lab11/observer/README.md

Observer
========

Observer is an indoor monitoring sensor platform that is optimized to work
with [GAP](https://github.com/lab11/gap).
