lab11/observer/contiki/apps/radio_bbb/resources_bbb/images/accel.png

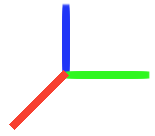
contiki/apps/radio_bbb/resources_bbb/images/accel.png
