lab11/observer/contiki/apps/radio_bbb/resources_bbb/images_2/accel.png

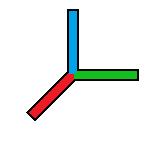
contiki/apps/radio_bbb/resources_bbb/images_2/accel.png
