lab11/observer/contiki/apps/radio_bbb/resources_bbb/images_2/humid.png

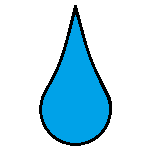
contiki/apps/radio_bbb/resources_bbb/images_2/humid.png
