lab11/observer/contiki/apps/radio_bbb/resources_bbb/images_2/light.png

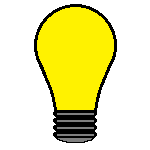
contiki/apps/radio_bbb/resources_bbb/images_2/light.png
