lab11/observer/contiki/apps/radio_bbb/resources_bbb/images_2/press_handle.png

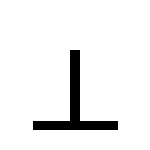
contiki/apps/radio_bbb/resources_bbb/images_2/press_handle.png
