lab11/observer/contiki/apps/radio_bbb/resources_bbb/images_2/template_6.png

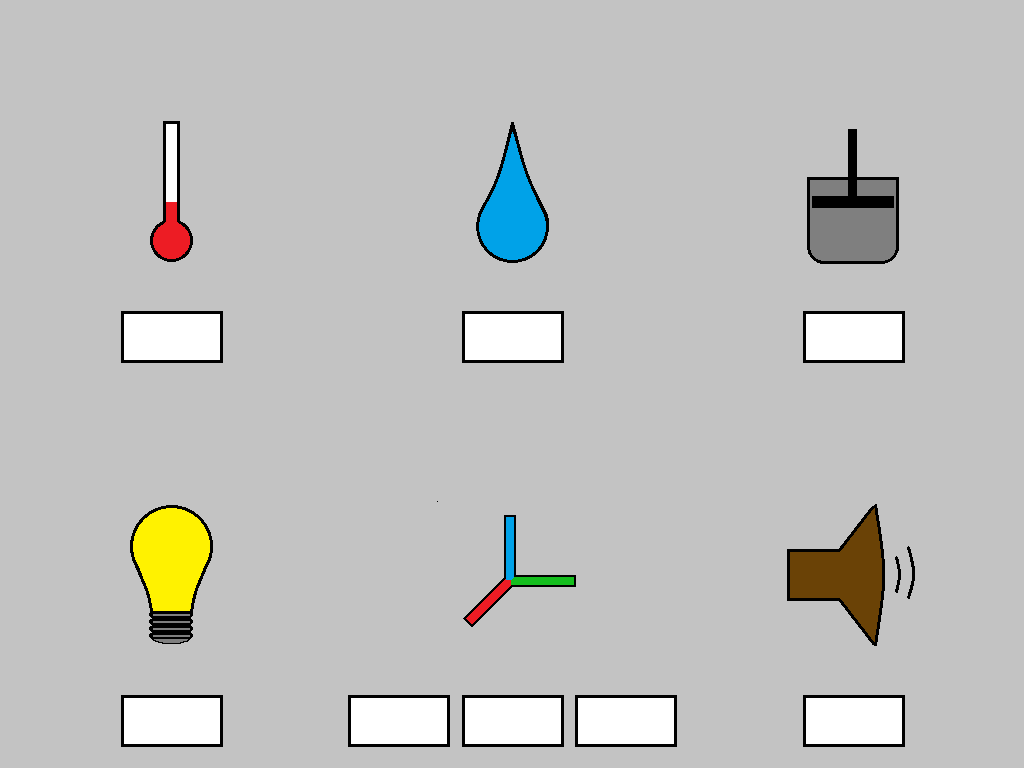
contiki/apps/radio_bbb/resources_bbb/images_2/template_6.png
