lab11/observer/hardware/ocape/rev_a/ocape_pcb.png

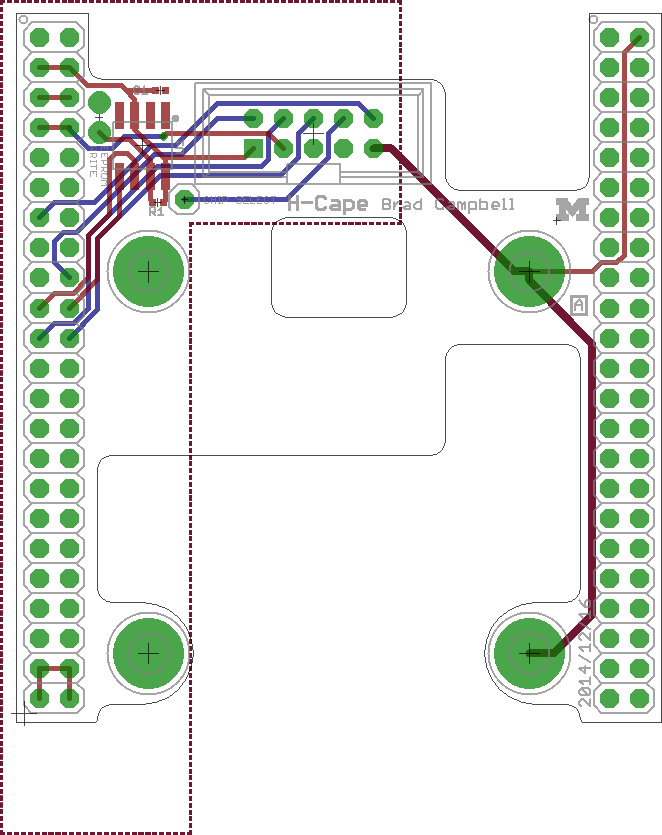
hardware/ocape/rev_a/ocape_pcb.png
