lab11/observer/hardware/ocape/rev_a/ocape.pdf

# BeagleBone Black Header

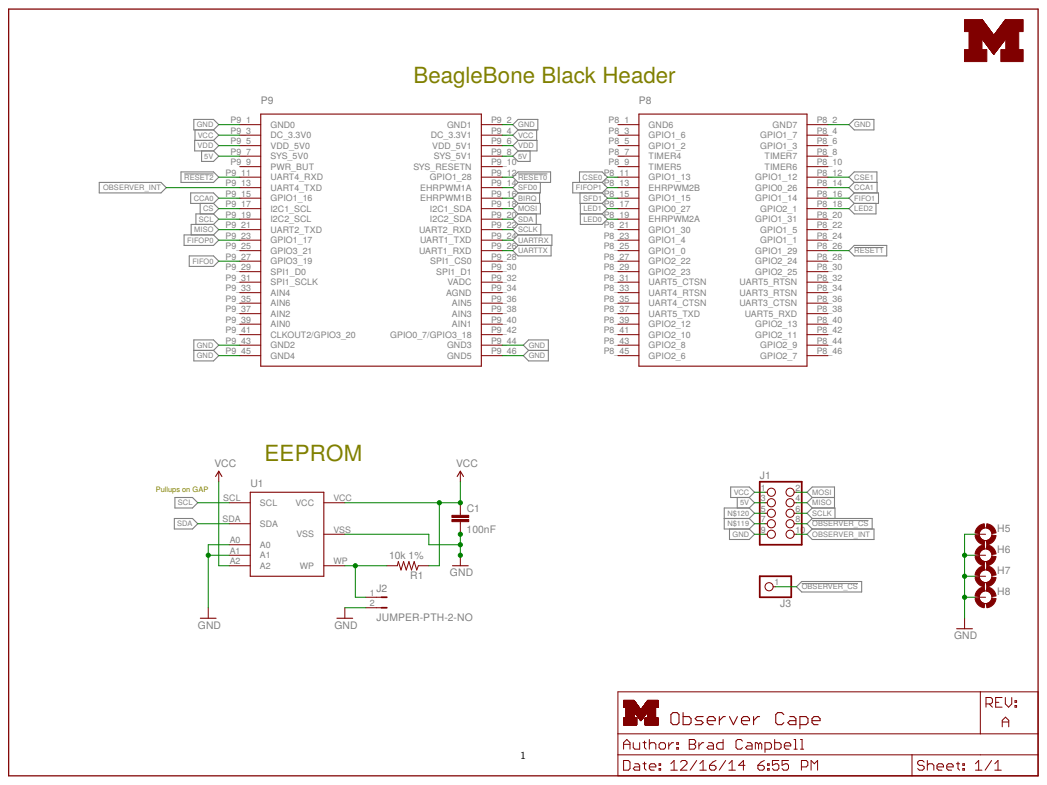
[picture p11: page 1]

Pullups on GAP VCC

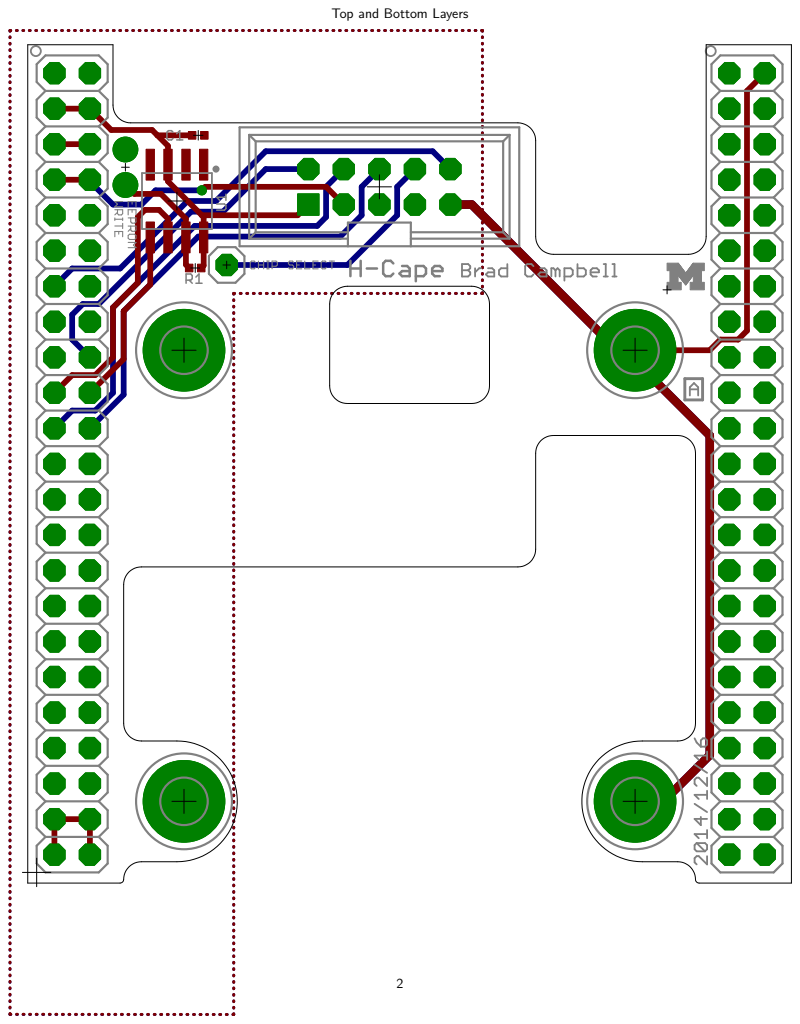
[picture p12: page 2]

Top and Bottom Layers

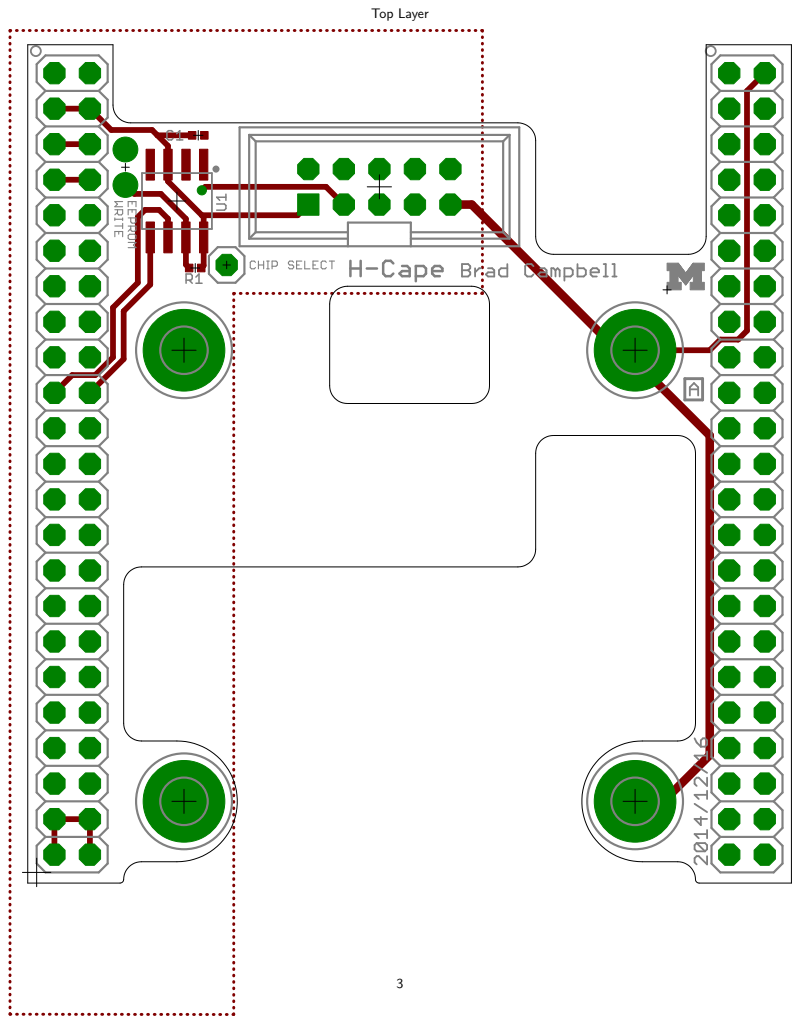
[picture p13: page 3]
Top Layer

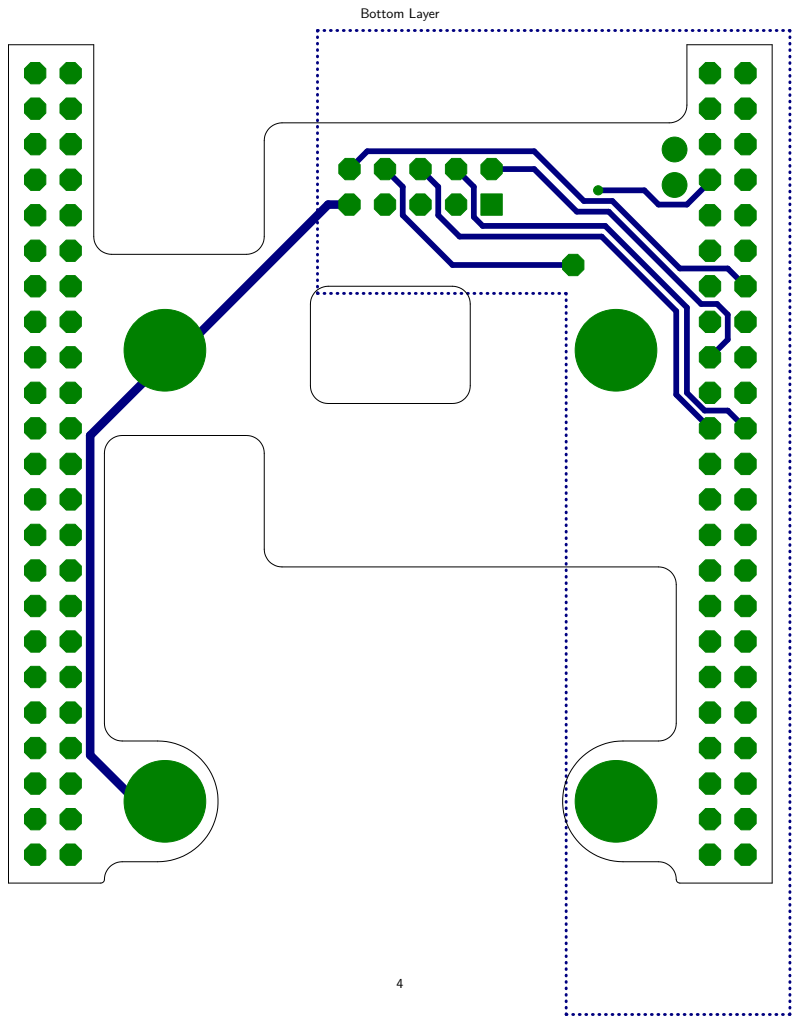
[picture p14: page 4]
Bottom Layer

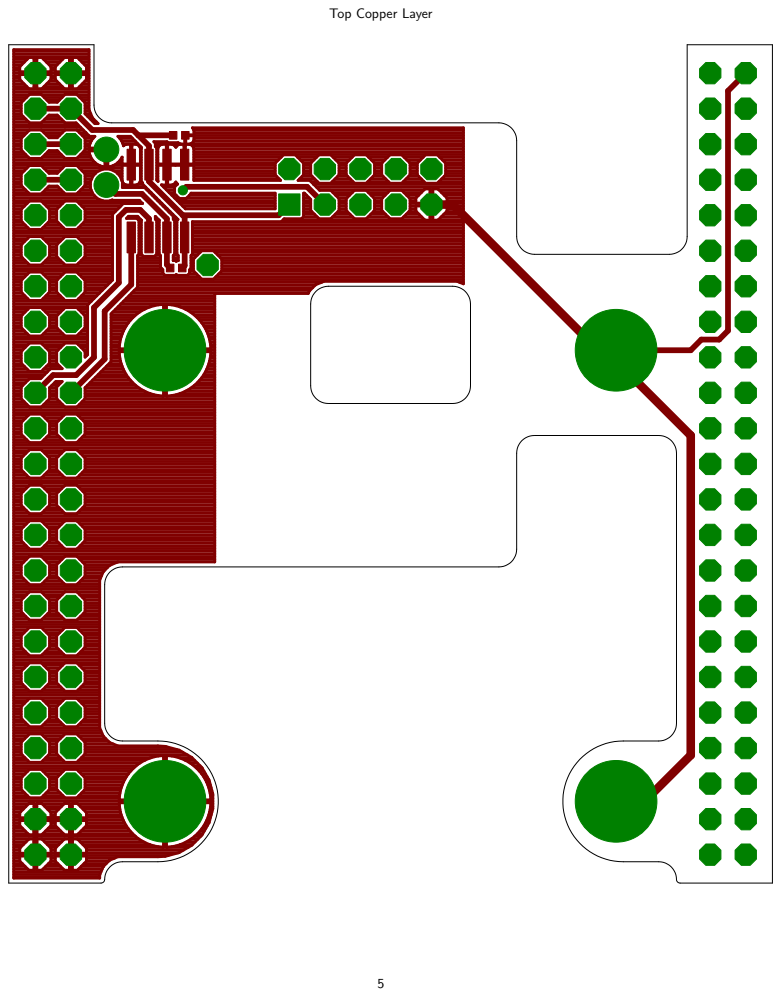
[picture p15: page 5]

Top Copper Layer

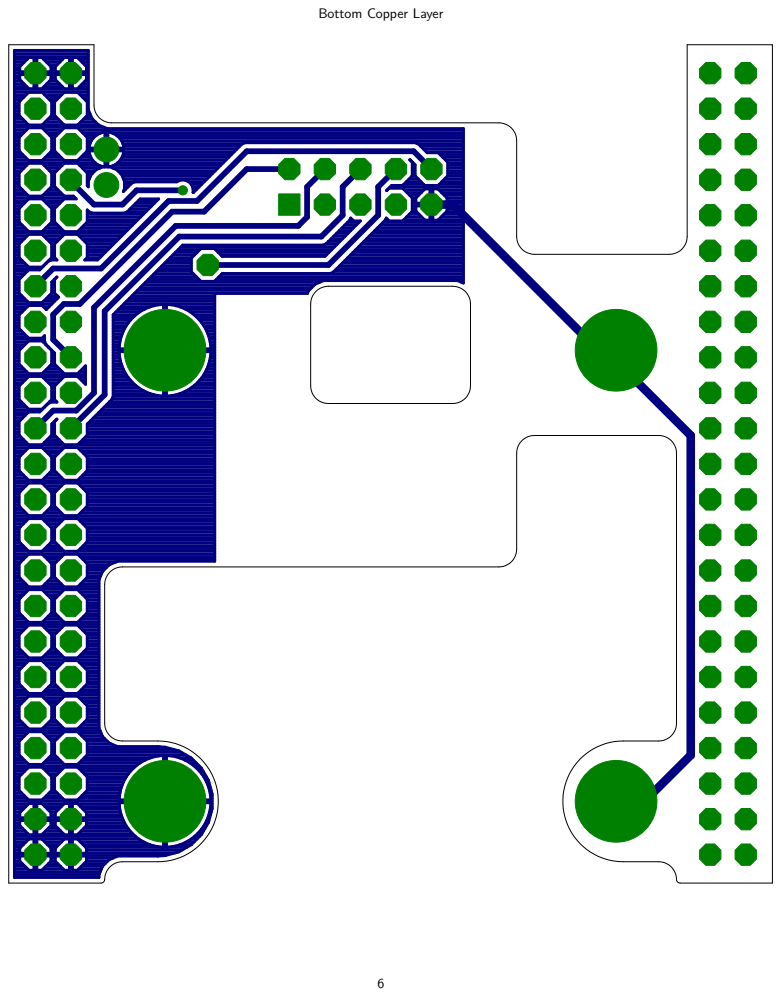
[picture p16: page 6]

Bottom Copper Layer

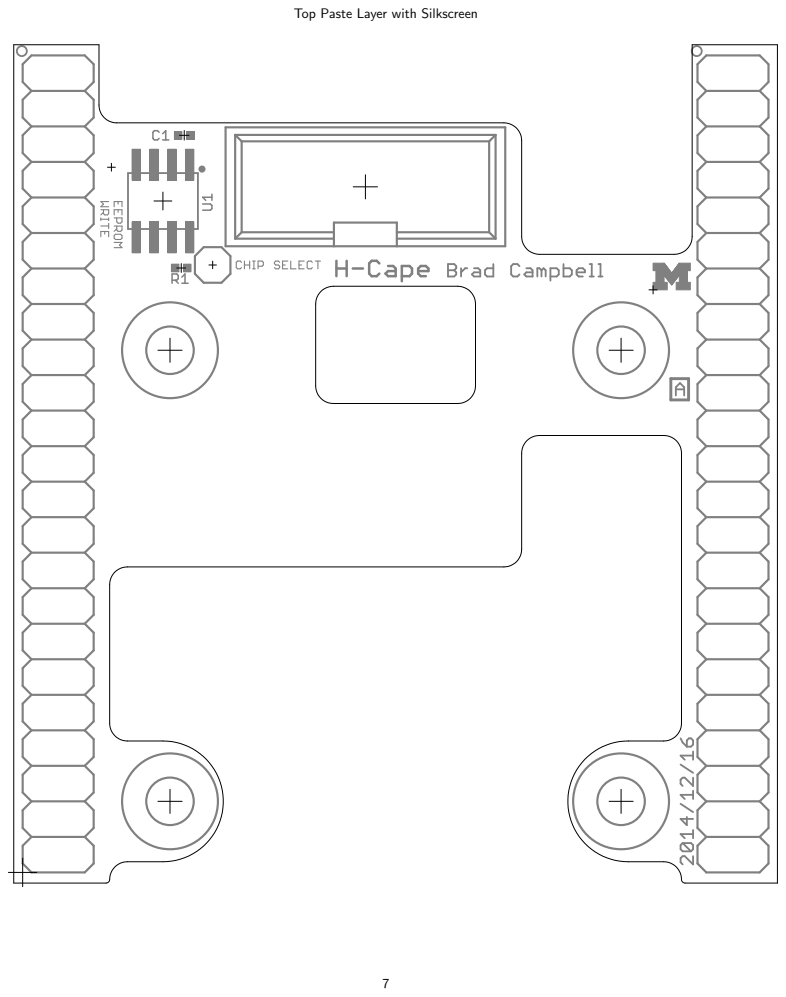
[picture p17: page 7]

Top Paste Layer with Silkscreen

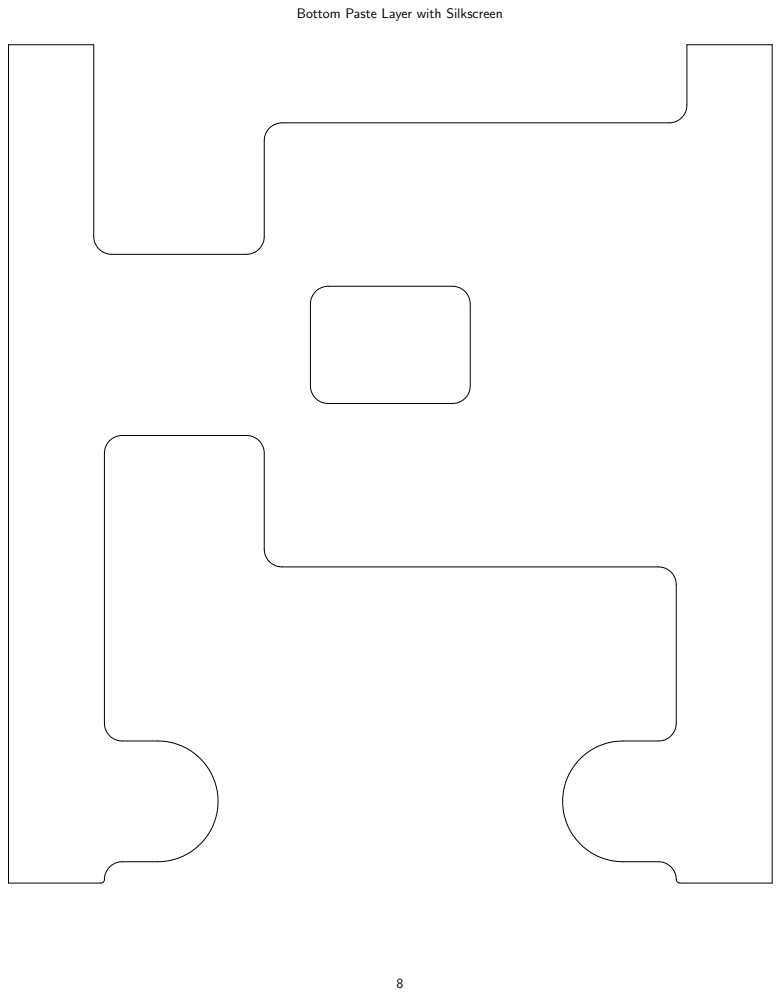
[picture p18: page 8]

Bottom Paste Layer with Silkscreen

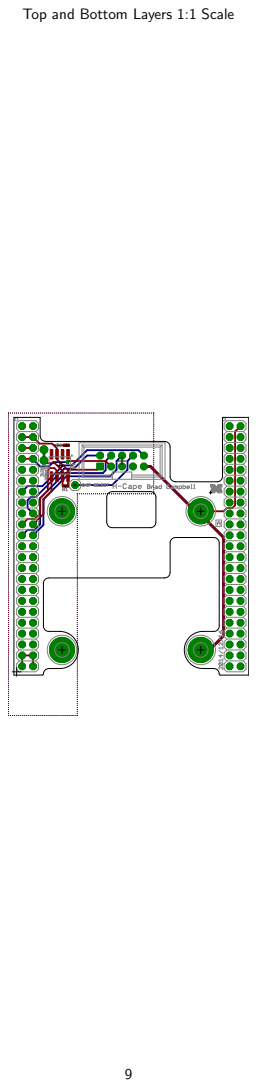
[picture p19: page 9]

Top and Bottom Layers 1:1 Scale

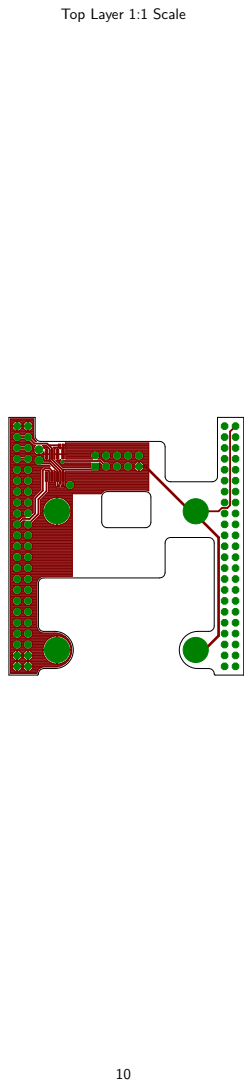
[picture p20: page 10]

Top Layer 1:1 Scale

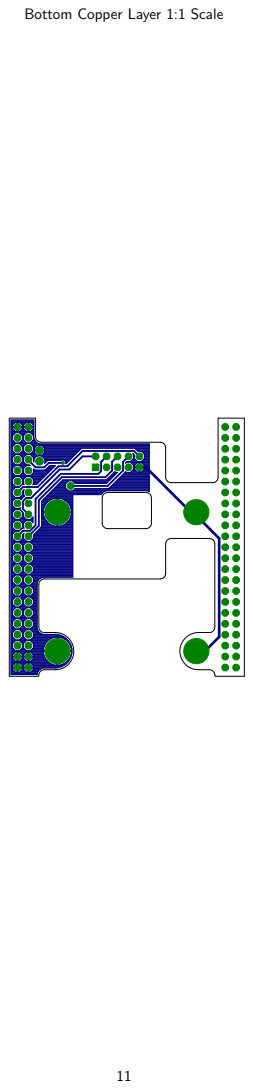
[picture p21: page 11]

Bottom Copper Layer 1:1 Scale

## Sheet1

Qty Value | Device
1 100nF | C-EUC0402

### 1 CON_HEADER_2X05-PTH+SHROUDED_A CON_HEADER_2X05-PTH+SHROUDED_A

1 JUMPER-PTH-2-NO | JUMPER-PTH-2-NO
1 | PINHD-1X1
1 BBB_HEADERS | BBB_HEADERS
1 10k 1% | R-US_R0402
1 CAT24C256WI-GT3 | CAT24C256WI-GT3

## Sheet1

Package | Parts
C0402 | C1
PINSHRD_PTH_2X05 | J1

### PTH-JUMPER-2-NO_NO_SILK J2

1X01 | J3
BBB_HEADERS | P9/P8
R0402 | R1
CAT24C256WI-GT3 | U1

## Sheet1

Description | DIGIKEY
CAPACITOR, European symbol | 490-1318-1-ND
2x05 pin header | ED1543-ND

### PIN HEADER Pin Header

RESISTOR, American symbol | RHM10.0KCDCT-ND

### 256kb Serial CMOS EEPROM, organized as 32,768 words of 8 bits each CAT24C256WI-GT3OSCT-ND
