lab11/observer/hardware/observer/rev_c/observer.brd

## EAGLE design hardware/observer/rev_c/observer.brd (2015-06-29, an earlier design)

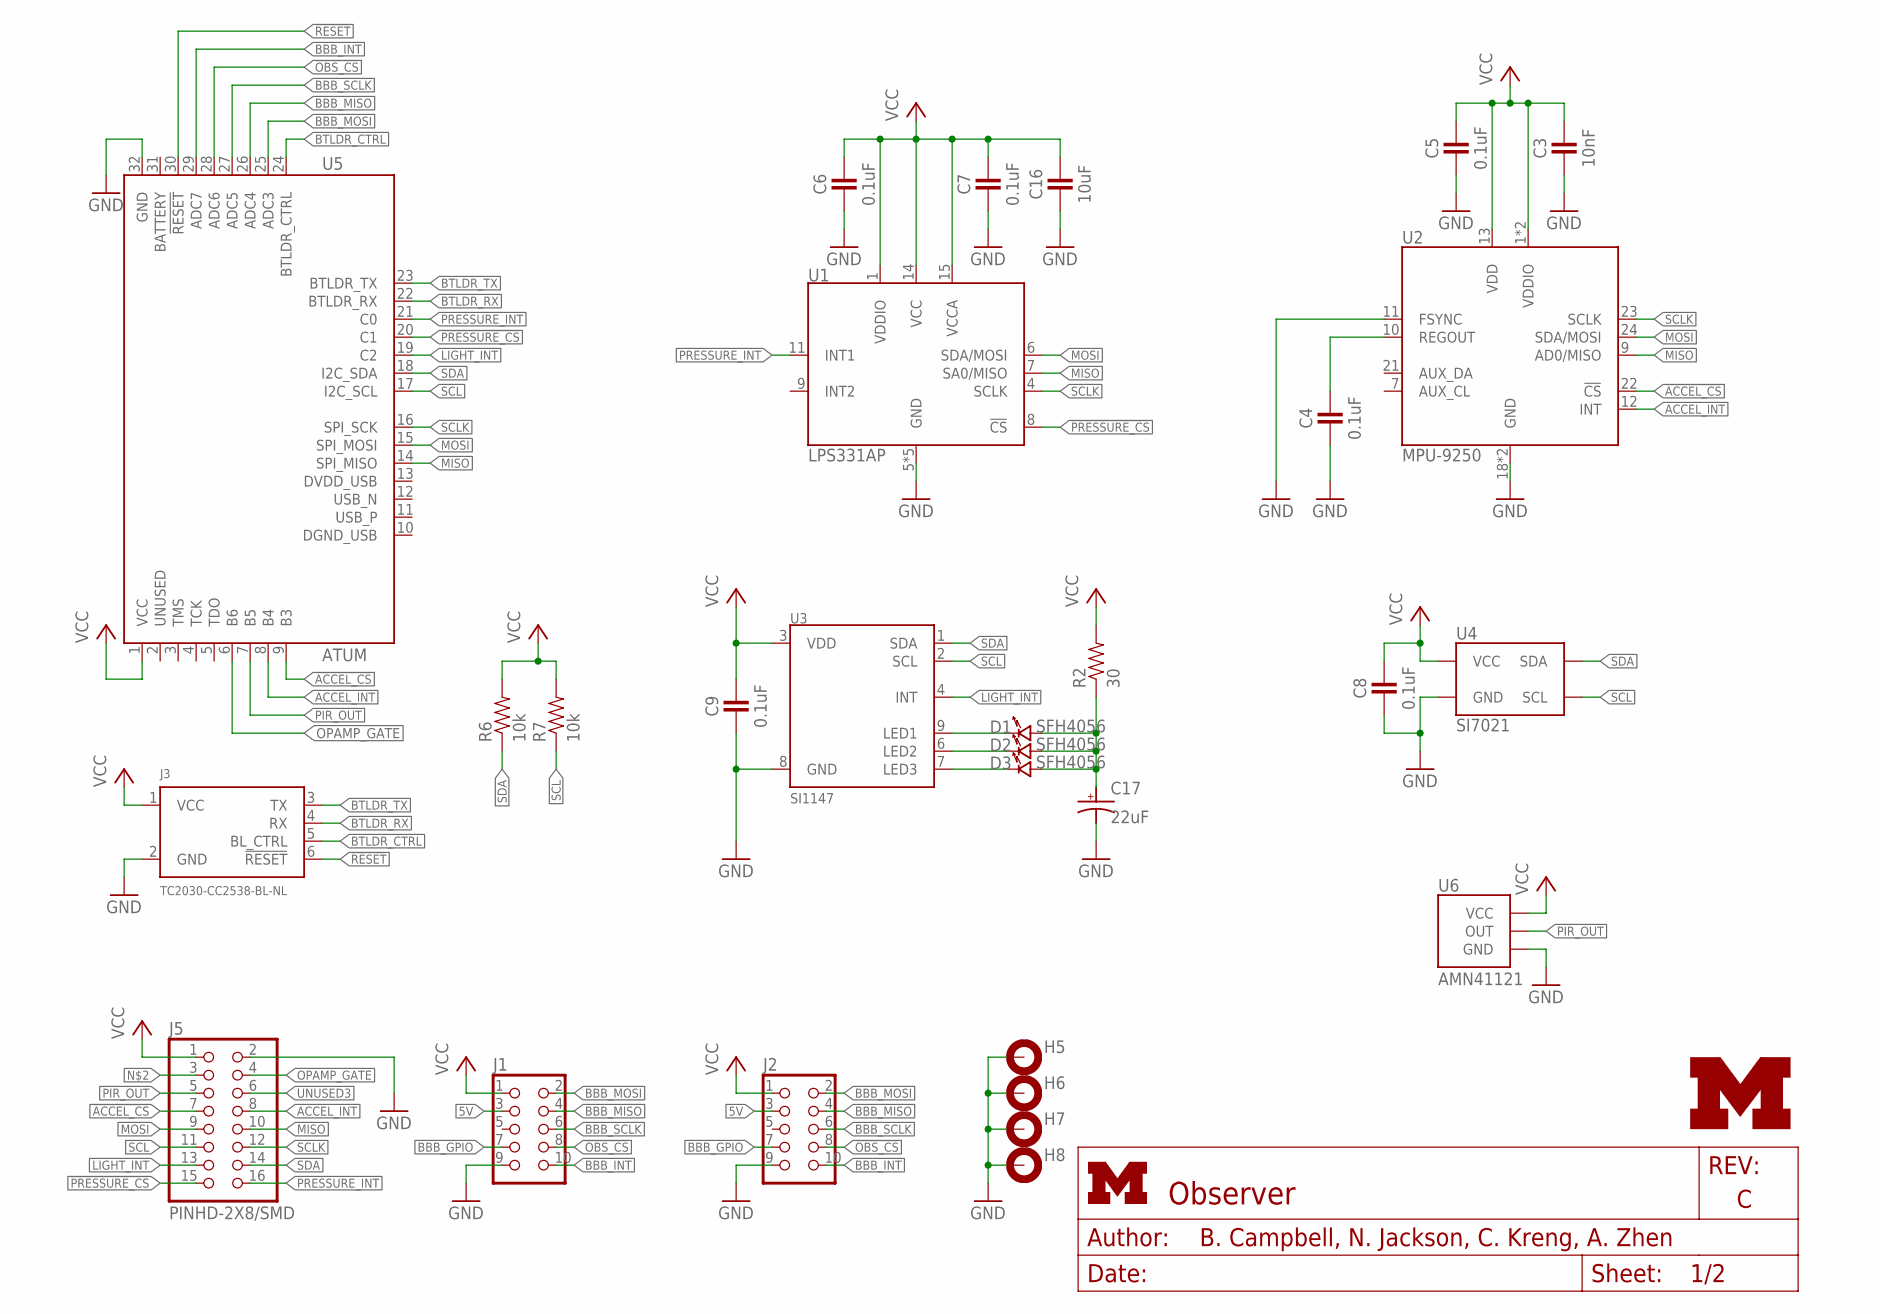
[picture p32: schematic observer.sch, sheet 1]

Parts:
C3: 10nF; 0402_CAP; DIGIKEY 490-1312-1-ND
C4, C5, C6, C7, C8, C9: 0.1uF; 0402_CAP; DIGIKEY 490-1318-1-ND
C16: 10uF; 0402_CAP; DIGIKEY 445-8919-1-ND
C17: 22uF; CAP0603; DIGIKEY 511-1493-1-ND
D1, D2, D3: SFH4056
H5, H6, H7, H8: MOUNT-PAD-ROUND3.2; 3,2-PAD
J1, J2: CON_HEADER_2X05-SMD+SHROUDED; PINSHRD_SMT_2X05; DIGIKEY S9185-ND
J3: TC2030-CC2538-BL-NL; TC2030-IDC-NL
J5: PINHD-2X8/SMD; 2X8/SMD
LOGO1: UMICH_SOLID_TINY; UMICH_SOLID_50MIL
R2: 30; 0402_RES; DIGIKEY RHM30CECT-ND
R6, R7: 10k; 0402_RES; DIGIKEY RHM10.0KCDCT-ND
U1: LPS331AP; HCLGA-16/3MM
U2: MPU-9250; QFN-24/3MM
U3: SI1147; QFN-10/2MM
U4: SI7021; DFN-6/3MM
U5: ATUM
U6: AMN41121; AMN2

Connections:
5V: J1.3, J2.3; also elsewhere on the board
!ACCEL_CS: J5.7, U2.22 (!CS), U5.9 (B3)
!OBS_CS: J1.8, J2.8, U5.28 (ADC6); also elsewhere on the board
!PRESSURE_CS: J5.15, U1.8 (!CS), U5.20 (C1)
!RESET: J3.6 (!RESET), U5.30 (!RESET)
ACCEL_INT: J5.8, U2.12 (INT), U5.8 (B4)
BBB_GPIO: J1.7, J2.7; also elsewhere on the board
BBB_INT: J1.10, J2.10, U5.29 (ADC7)
BBB_MISO: J1.4, J2.4, U5.26 (ADC4); also elsewhere on the board
BBB_MOSI: J1.2, J2.2, U5.25 (ADC3); also elsewhere on the board
BBB_SCLK: J1.6, J2.6, U5.27 (ADC5); also elsewhere on the board
BTLDR_CTRL: J3.5 (BL_CTRL), U5.24 (BTLDR_CTRL)
BTLDR_RX: J3.4 (RX), U5.22 (BTLDR_RX)
BTLDR_TX: J3.3 (TX), U5.23 (BTLDR_TX)
GND: C3.2, C4.2, C5.2, C6.2, C7.2, C8.2, C9.2, C16.2, C17.NEG (ANODE), H5.B3,2, H6.B3,2, H7.B3,2, H8.B3,2, J1.9, J2.9, J3.2 (GND), J5.2, U1.5 (GND), U1.10 (GND), U1.12 (GND), U1.13 (GND), U1.16 (GND), U2.11 (FSYNC), U2.18 (GND), U2.20 (GND), U3.8 (GND), U4.2 (GND), U5.32 (GND), U6.GND; also elsewhere on the board
LIGHT_INT: J5.13, U3.4 (INT), U5.19 (C2)
MISO: J5.10, U1.7 (SA0/MISO), U2.9 (AD0/MISO), U5.14 (SPI_MISO)
MOSI: J5.9, U1.6 (SDA/MOSI), U2.24 (SDA/MOSI), U5.15 (SPI_MOSI)
unnamed: C4.1, U2.10 (REGOUT)
unnamed: D1.CATHODE, U3.9 (LED1)
unnamed: D2.CATHODE, U3.6 (LED2)
unnamed: D3.CATHODE, U3.7 (LED3)
unnamed: C17.POS (CATHODE), D1.ANODE, D2.ANODE, D3.ANODE, R2.1
OPAMP_GATE: J5.4, U5.6 (B6); also elsewhere on the board
PIR_OUT: J5.5, U5.7 (B5), U6.OUT
PRESSURE_INT: J5.16, U1.11 (INT1), U5.21 (C0)
SCL: J5.11, R7.1, U3.2 (SCL), U4.6 (SCL), U5.17 (I2C_SCL); also elsewhere on the board
SCLK: J5.12, U1.4 (SCLK), U2.23 (SCLK), U5.16 (SPI_SCK)
SDA: J5.14, R6.1, U3.1 (SDA), U4.1 (SDA), U5.18 (I2C_SDA); also elsewhere on the board
UNUSED3: J5.6
VCC: C3.1, C5.1, C6.1, C7.1, C8.1, C9.1, C16.1, J1.1, J2.1, J3.1 (VCC), J5.1, R2.2, R6.2, R7.2, U1.1 (VDDIO), U1.14 (VCC), U1.15 (VCCA), U2.1 (VDDIO), U2.8 (VDDIO), U2.13 (VDD), U3.3 (VDD), U4.5 (VCC), U5.1 (VCC), U6.VCC; also elsewhere on the board

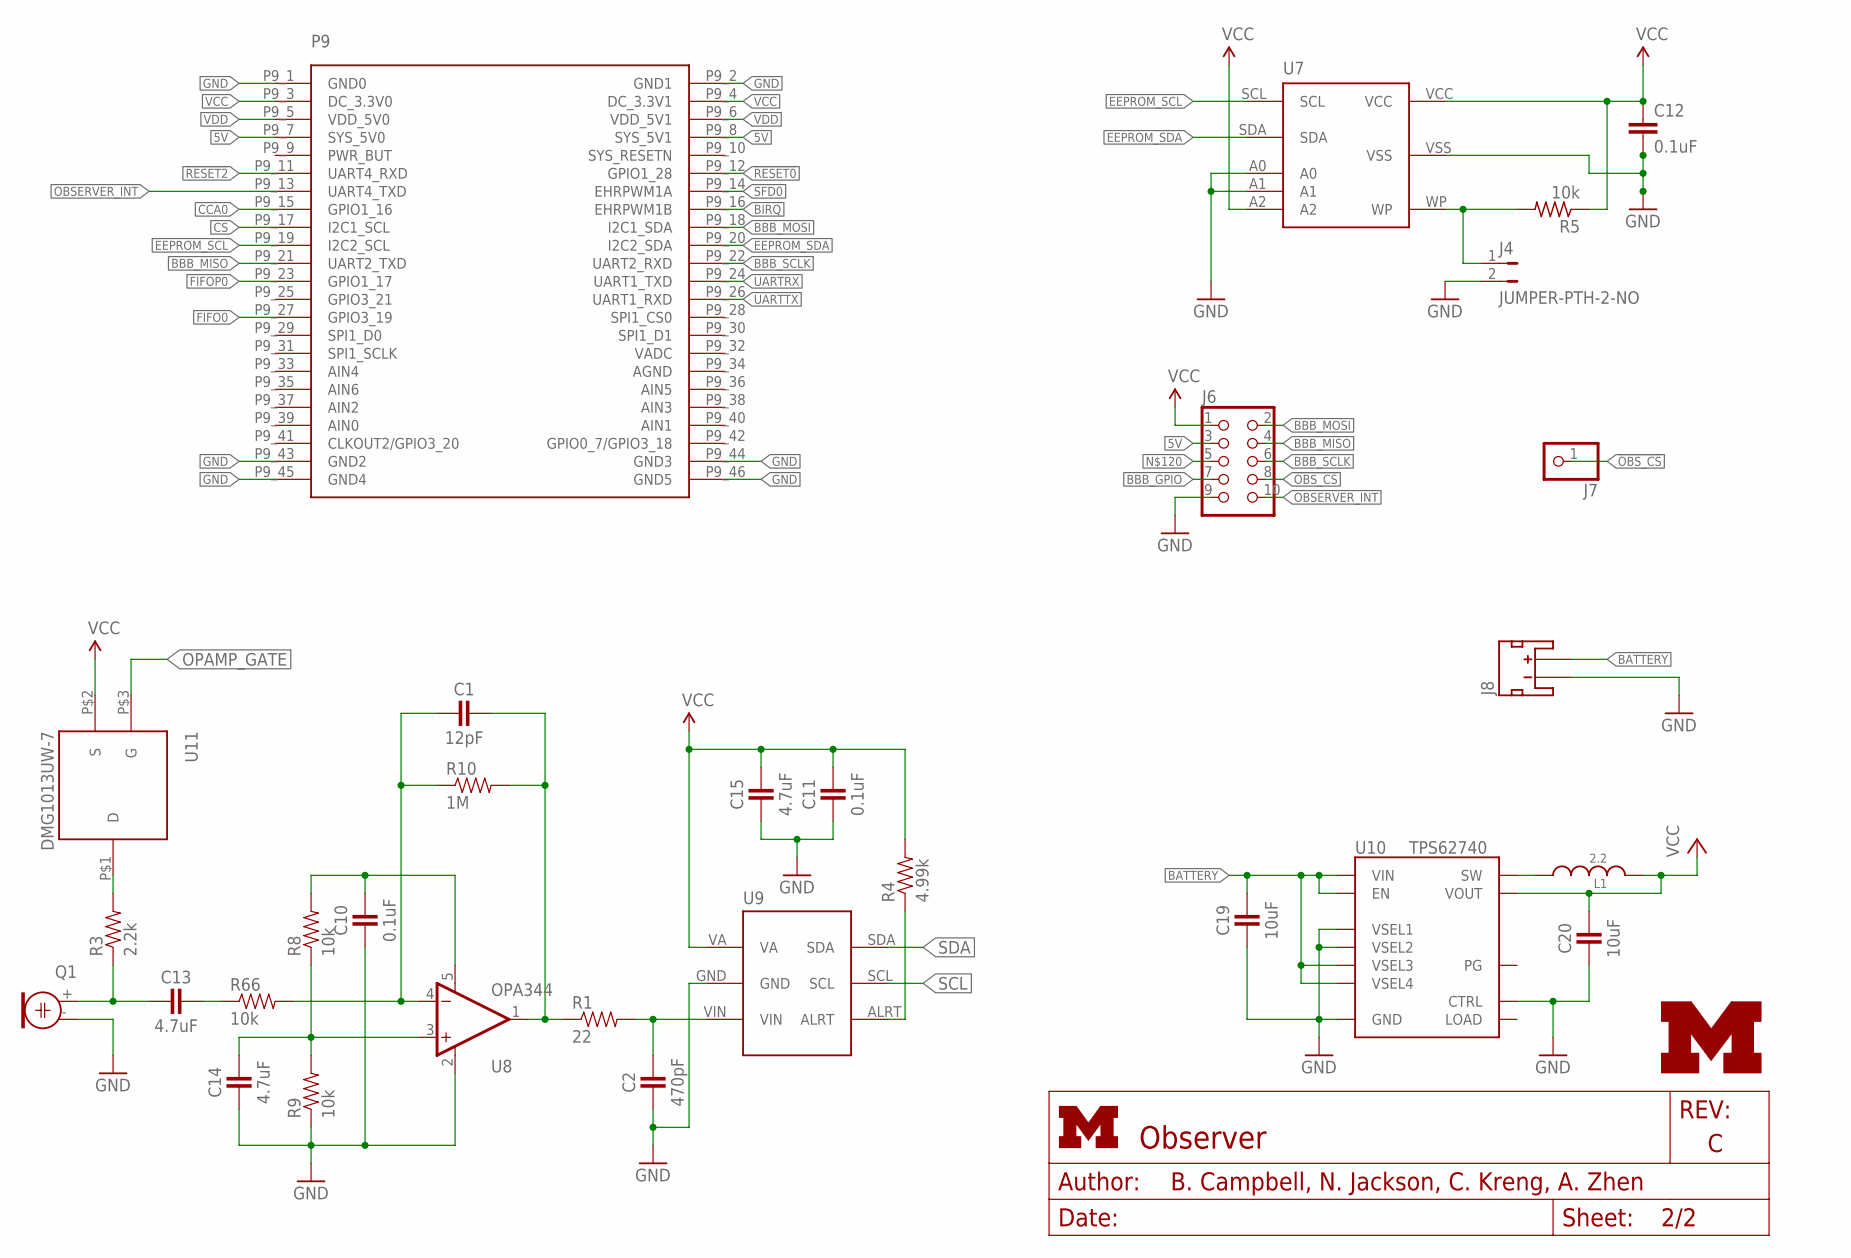
[picture p33: schematic observer.sch, sheet 2]

Parts:
C1: 12pF; 0402_CAP
C2: 470pF; 0402_CAP
C10, C11: 0.1uF; 0402_CAP
C12: 0.1uF; C0402; DIGIKEY 490-1318-1-ND
C13, C14, C15: 4.7uF; 0402_CAP
C19, C20: 10uF; 0603_CAP; DIGIKEY 490-7316-1-ND
J4: JUMPER-PTH-2-NO; PTH-JUMPER-2-NO_NO_SILK
J6: CON_HEADER_2X05-PTH+SHROUDED_A; PINSHRD_PTH_2X05
J7: PINHD-1X1; 1X01
J8: JST_2MM_MALE; JST-2-SMD
L1: 2.2; MIPSZ201D
LOGO2: UMICH_SOLID_TINY; UMICH_SOLID_50MIL
P9/P8: BBB_HEADER; BBB_HEADERS
Q1: ELECTRET; ELECTRET_9.7
R1: 22; 0402_RES
R3: 2.2k; 0402_RES
R4: 4.99k; 0402_RES
R5: 10k; R0402; DIGIKEY RHM1.00MCDCT-ND
R8, R9, R66: 10k; 0402_RES
R10: 1M; 0402_RES
U7: CAT24C256WI-GT3
U8: OPA344; SOT23-5
U9: ADC121C021
U10: TPS62740; R-PWSON-12
U11: DMG1013UW-7; SOT-323

Connections:
5V: J6.3, P9/P8.P9_7 (SYS_5V0), P9/P8.P9_8 (SYS_5V1); also elsewhere on the board
!OBS_CS: J6.8, J7.1; also elsewhere on the board
!RESET0: P9/P8.P9_12 (GPIO1_28)
!RESET2: P9/P8.P9_11 (UART4_RXD)
BATTERY: C19.1, J8.2 (+), U10.1 (VIN), U10.8 (VSEL4), U10.9 (VSEL3), U10.12 (EN)
BBB_GPIO: J6.7; also elsewhere on the board
BBB_MISO: J6.4, P9/P8.P9_21 (UART2_TXD); also elsewhere on the board
BBB_MOSI: J6.2, P9/P8.P9_18 (I2C1_SDA); also elsewhere on the board
BBB_SCLK: J6.6, P9/P8.P9_22 (UART2_RXD); also elsewhere on the board
BIRQ: P9/P8.P9_16 (EHRPWM1B)
CCA0: P9/P8.P9_15 (GPIO1_16)
CS: P9/P8.P9_17 (I2C1_SCL)
EEPROM_SCL: P9/P8.P9_19 (I2C2_SCL), U7.SCL
EEPROM_SDA: P9/P8.P9_20 (I2C2_SDA), U7.SDA
FIFO0: P9/P8.P9_27 (GPIO3_19)
FIFOP0: P9/P8.P9_23 (GPIO1_17)
GND: C2.2, C10.2, C11.2, C12.2, C14.2, C15.2, C19.2, C20.2, J4.2, J6.9, J8.1 (-), P9/P8.P9_1 (GND0), P9/P8.P9_2 (GND1), P9/P8.P9_43 (GND2), P9/P8.P9_44 (GND3), P9/P8.P9_45 (GND4), P9/P8.P9_46 (GND5), Q1.- (1), R9.1, U7.A0, U7.A1, U7.VSS, U8.2 (V-), U9.GND, U10.3 (GND), U10.4 (CTRL), U10.10 (VSEL2), U10.11 (VSEL1), U10.NC (GND); also elsewhere on the board
MIC_AIN: C1.1, R1.1, R10.2, U8.1 (OUT)
MIC_INT: R4.1, U9.ALRT
unnamed: C13.2, Q1.+ (2), R3.1
unnamed: C13.1, R66.1
unnamed: C1.2, R10.1, R66.2, U8.4 (-IN)
unnamed: C14.1, R8.1, R9.2, U8.3 (+IN)
unnamed: C2.1, R1.2, U9.VIN
unnamed: L1.1, U10.2 (SW)
unnamed: C10.1, R8.2, U8.5 (V+)
unnamed: R3.2, U11.P$1 (D)
unnamed: J4.1, R5.2, U7.WP
OBSERVER_INT: J6.10, P9/P8.P9_13 (UART4_TXD)
OPAMP_GATE: U11.P$3 (G); also elsewhere on the board
SCL: U9.SCL; also elsewhere on the board
SDA: U9.SDA; also elsewhere on the board
SFD0: P9/P8.P9_14 (EHRPWM1A)
UARTRX: P9/P8.P9_24 (UART1_TXD)
UARTTX: P9/P8.P9_26 (UART1_RXD)
VCC: C11.1, C12.1, C15.1, C20.1, J6.1, L1.2, P9/P8.P9_3 (DC_3.3V0), P9/P8.P9_4 (DC_3.3V1), R4.2, R5.1, U7.A2, U7.VCC, U9.VA, U10.5 (VOUT), U11.P$2 (S); also elsewhere on the board
VDD: P9/P8.P9_5 (VDD_5V0), P9/P8.P9_6 (VDD_5V1)

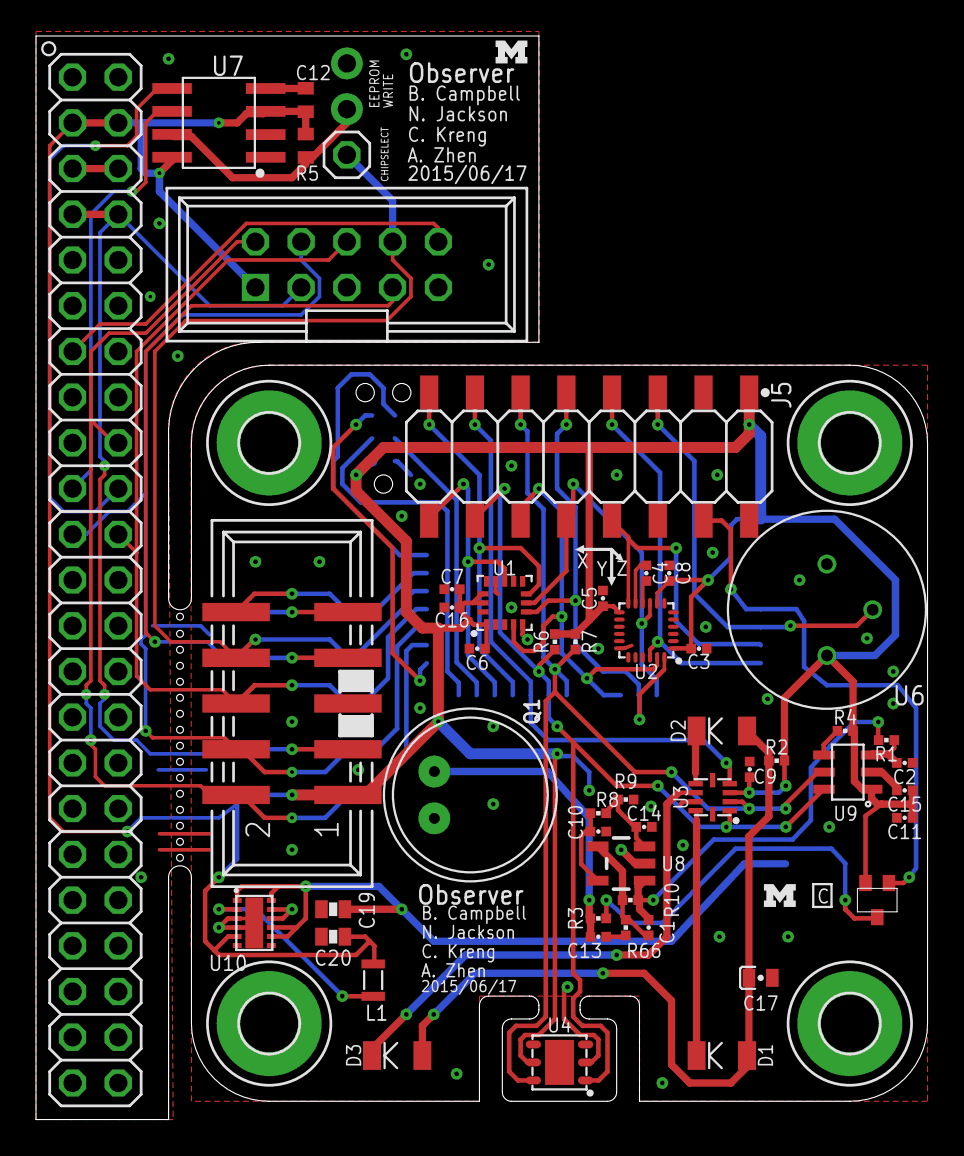
[picture p34: board observer.brd from above]

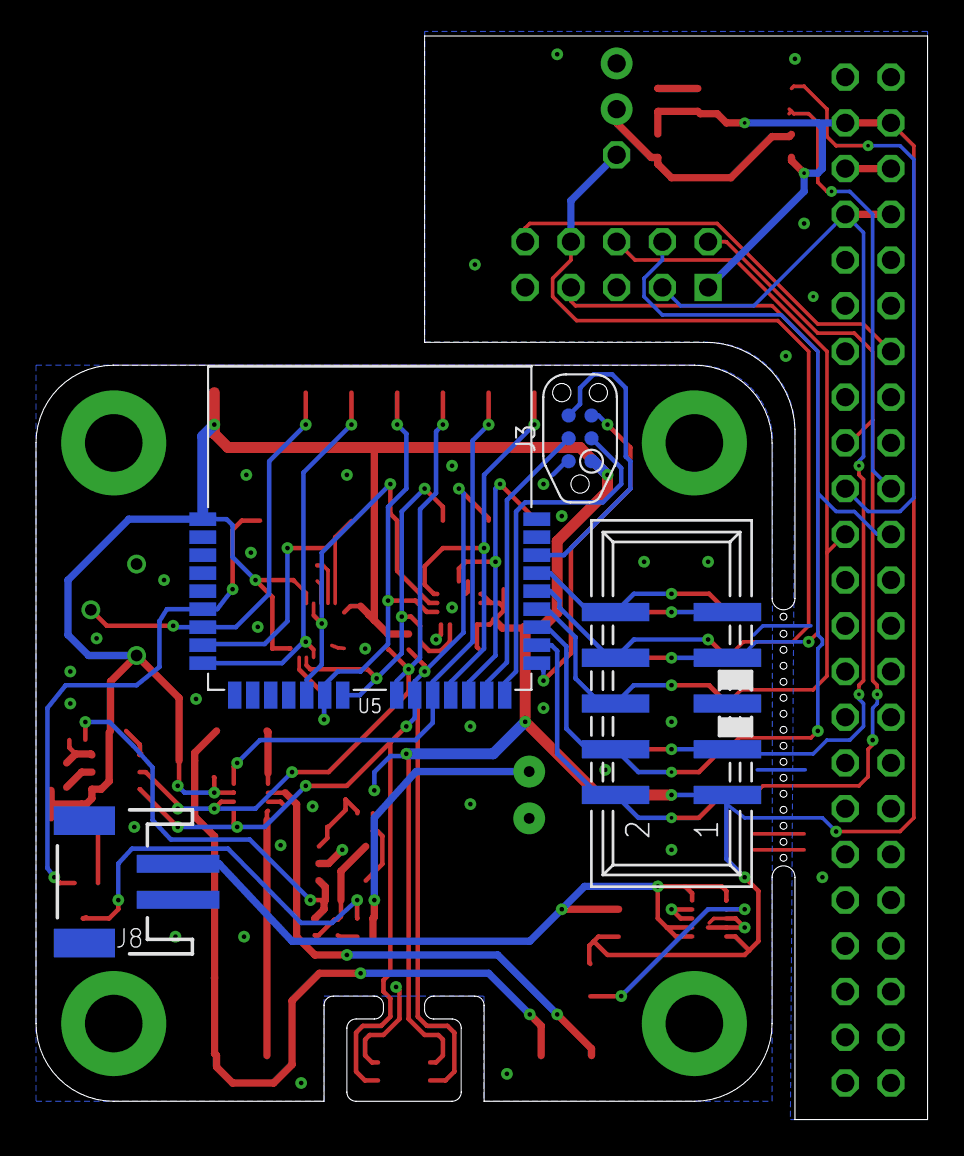
[picture p35: board observer.brd from below]

Board: 2 copper layers, 49.5 x 60.2 mm, 61 parts (4 on the bottom side), 46 nets.
