lab11/observer/hardware/ocape/rev_a/ocape.brd

## EAGLE design hardware/ocape/rev_a/ocape.brd (2015-04-04)

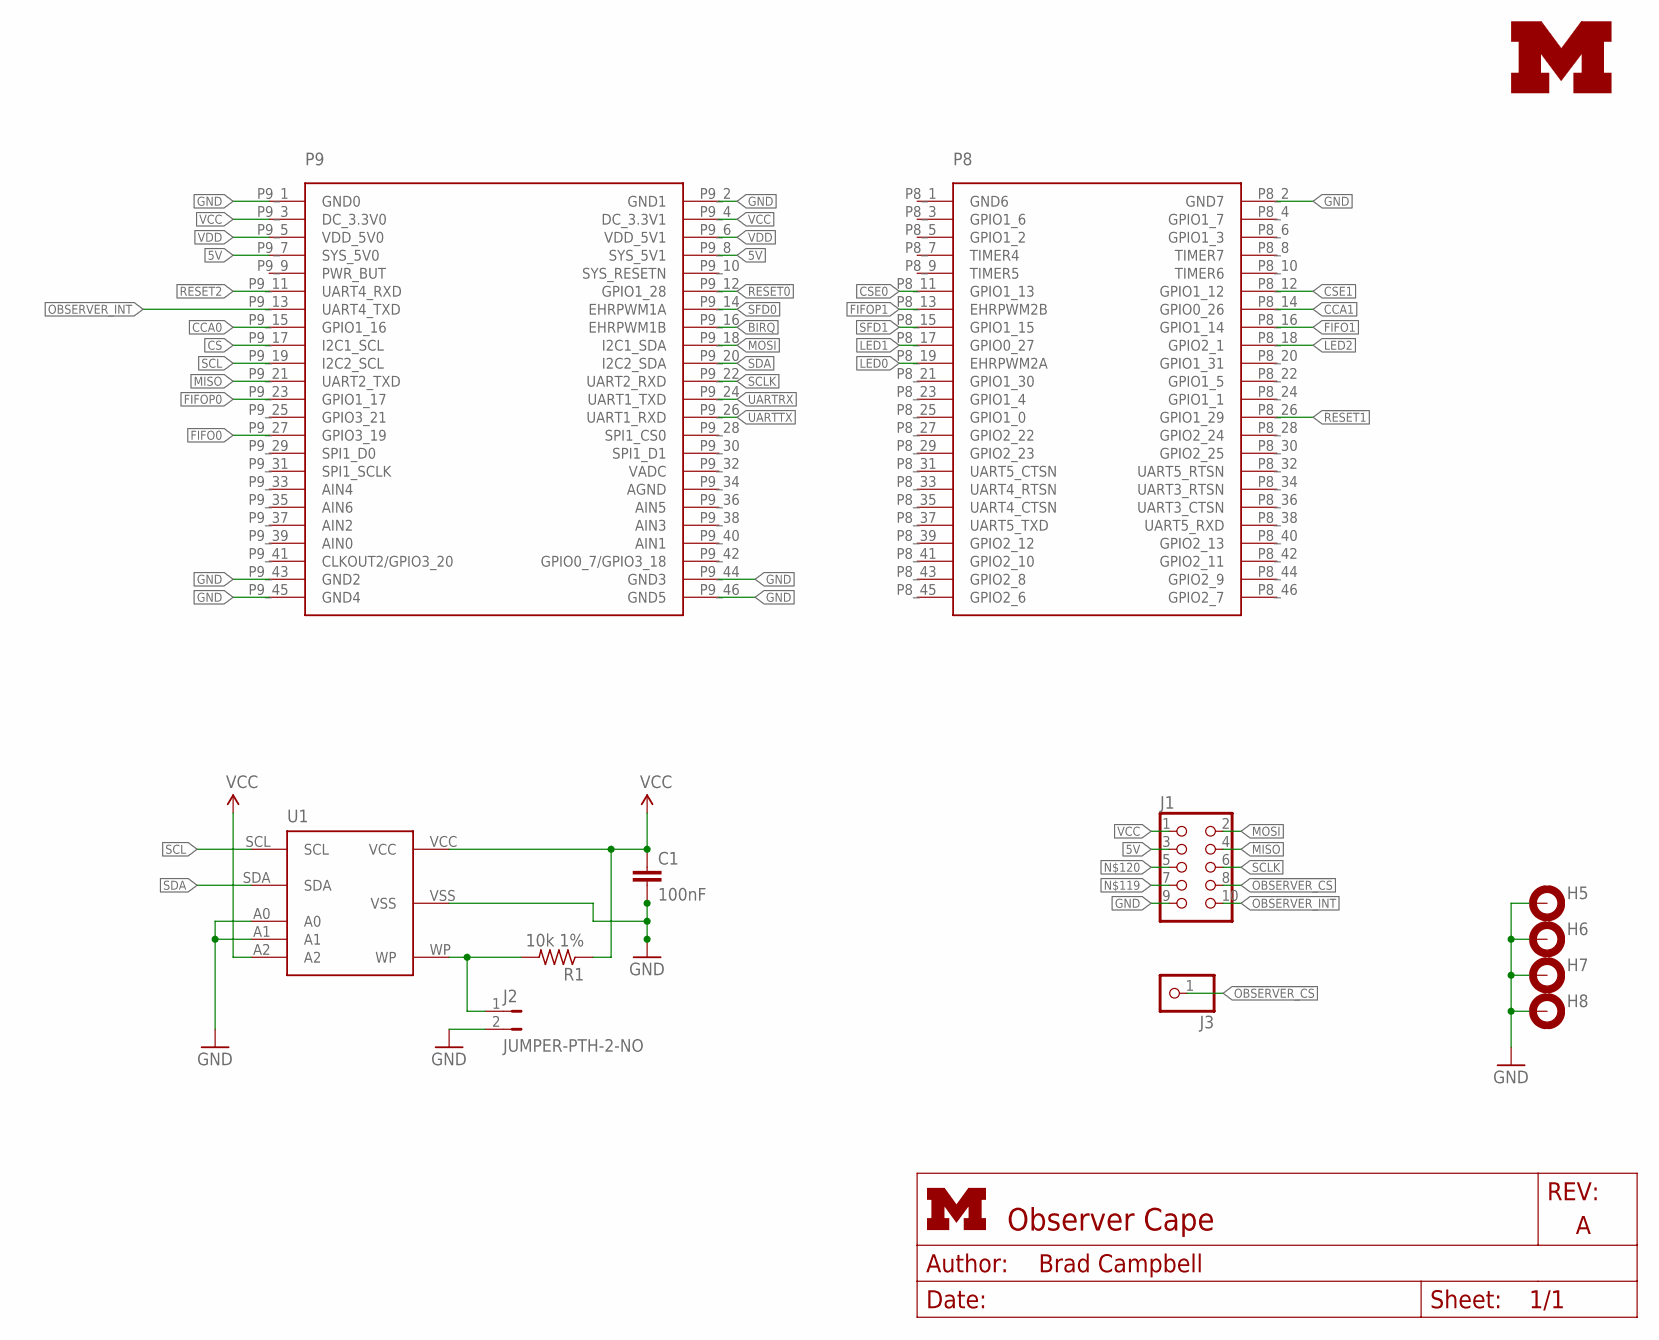
[picture p36: schematic ocape.sch]

Parts:
C1: 100nF; C0402; DIGIKEY 490-1318-1-ND
H5, H6, H7, H8: MOUNT-PAD-ROUND3.2; 3,2-PAD
J1: CON_HEADER_2X05-PTH+SHROUDED_A; PINSHRD_PTH_2X05
J2: JUMPER-PTH-2-NO; PTH-JUMPER-2-NO_NO_SILK
J3: PINHD-1X1; 1X01
LOGO1: UMICH_SOLID_SMALL; UMICH_SOLID_75MIL
P9/P8: BBB_HEADERS
R1: 10k 1%; R0402; DIGIKEY RHM1.00MCDCT-ND
U1: CAT24C256WI-GT3

Connections:
5V: J1.3, P9/P8.P9_7 (SYS_5V0), P9/P8.P9_8 (SYS_5V1)
!OBSERVER_CS: J1.8, J3.1
!RESET0: P9/P8.P9_12 (GPIO1_28)
!RESET1: P9/P8.P8_26 (GPIO1_29)
!RESET2: P9/P8.P9_11 (UART4_RXD)
BIRQ: P9/P8.P9_16 (EHRPWM1B)
CCA0: P9/P8.P9_15 (GPIO1_16)
CCA1: P9/P8.P8_14 (GPIO0_26)
CS: P9/P8.P9_17 (I2C1_SCL)
CSE0: P9/P8.P8_11 (GPIO1_13)
CSE1: P9/P8.P8_12 (GPIO1_12)
FIFO0: P9/P8.P9_27 (GPIO3_19)
FIFO1: P9/P8.P8_16 (GPIO1_14)
FIFOP0: P9/P8.P9_23 (GPIO1_17)
FIFOP1: P9/P8.P8_13 (EHRPWM2B)
GND: C1.2, H5.B3,2, H6.B3,2, H7.B3,2, H8.B3,2, J1.9, J2.2, P9/P8.P8_2 (GND7), P9/P8.P9_1 (GND0), P9/P8.P9_2 (GND1), P9/P8.P9_43 (GND2), P9/P8.P9_44 (GND3), P9/P8.P9_45 (GND4), P9/P8.P9_46 (GND5), U1.A0, U1.A1, U1.VSS
LED0: P9/P8.P8_19 (EHRPWM2A)
LED1: P9/P8.P8_17 (GPIO0_27)
LED2: P9/P8.P8_18 (GPIO2_1)
MISO: J1.4, P9/P8.P9_21 (UART2_TXD)
MOSI: J1.2, P9/P8.P9_18 (I2C1_SDA)
unnamed: J2.1, R1.2, U1.WP
OBSERVER_INT: J1.10, P9/P8.P9_13 (UART4_TXD)
SCL: P9/P8.P9_19 (I2C2_SCL), U1.SCL
SCLK: J1.6, P9/P8.P9_22 (UART2_RXD)
SDA: P9/P8.P9_20 (I2C2_SDA), U1.SDA
SFD0: P9/P8.P9_14 (EHRPWM1A)
SFD1: P9/P8.P8_15 (GPIO1_15)
UARTRX: P9/P8.P9_24 (UART1_TXD)
UARTTX: P9/P8.P9_26 (UART1_RXD)
VCC: C1.1, J1.1, P9/P8.P9_3 (DC_3.3V0), P9/P8.P9_4 (DC_3.3V1), R1.1, U1.A2, U1.VCC
VDD: P9/P8.P9_5 (VDD_5V0), P9/P8.P9_6 (VDD_5V1)

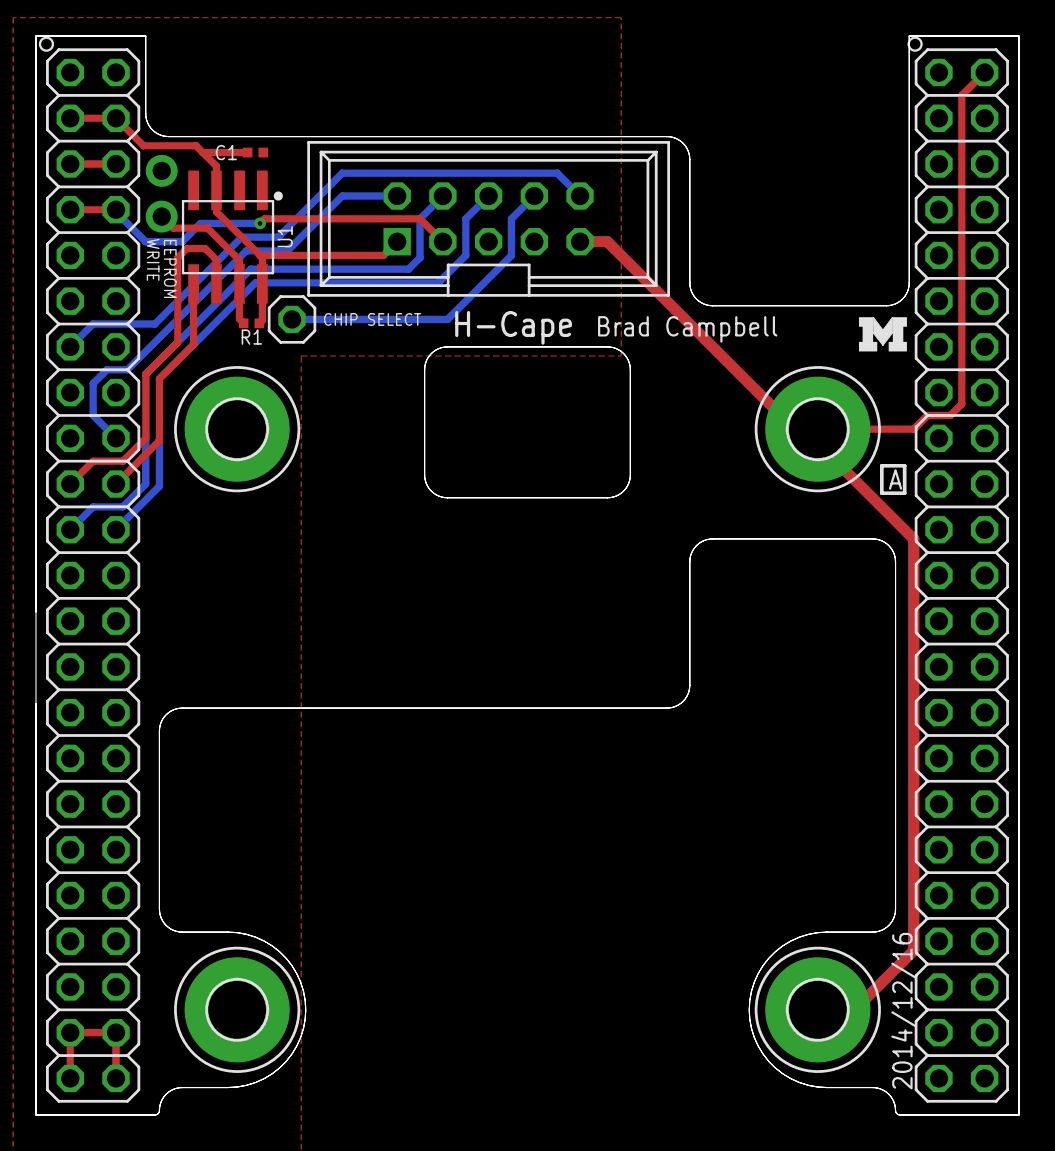
[picture p37: board ocape.brd from above]

Board: 4 copper layers, 54.6 x 59.9 mm, 12 parts (0 on the bottom side), 12 nets.
