lab11/observer/contiki/dev/mpu9250/mpu9250.h

#ifndef MPU9250_H
#define MPU9250_H

#define MPU9250_DBG 1

#define MPU9250_STARTUP_TIME 0.1*CLOCK_SECOND

// I2C address 0x69 could be 0x68 depends on your wiring.
#define MPU9250_I2C_ADDRESS  0x69;

// SPI chipselect port and pin
#define MPU9250_CS_PORT           GPIO_B_NUM
#define MPU9250_CS_PIN			  3

// GPIO Interrupt port and pin
#define MPU9250_INT_PORT           GPIO_B_NUM
#define MPU9250_INT_PIN            4
#define MPU9250_INT_VECTOR         NVIC_INT_GPIO_PORT_B

#define MPU9250_READ_MASK		   0x80
#define MPU9250_WRITE_MASK		   0x7F
#define MPU9250_ACCEL_ENABLE_MASK  0xC7
#define MPU9250_GYRO_DISABLE_MASK  0x07
#define MPU9250_ACCEL2_DLPF_ENABLE_MASK 0x08
#define MPU9250_ACCEL2_DLPF_184_MASK 0x01

// Register names according to the datasheet.
// According to the InvenSense document
// "MPU-9250 Register Map and Descriptions Revision 1.4",

#define MPU9250_SELF_TEST_X_GYRO   0x00   // R/W
#define MPU9250_SELF_TEST_Y_GYRO   0x01   // R/W
#define MPU9250_SELF_TEST_Z_GYRO   0x02   // R/W
#define MPU9250_SELF_TEST_X_ACCEL  0x0D   // R/W
#define MPU9250_SELF_TEST_Y_ACCEL  0x0E   // R/W
#define MPU9250_SELF_TEST_Z_ACCEL  0x0F   // R/W

#define MPU9250_SMPLRT_DIV         0x19   // R/W
#define MPU9250_CONFIG             0x1A   // R/W
#define MPU9250_GYRO_CONFIG        0x1B   // R/W
#define MPU9250_ACCEL_CONFIG       0x1C   // R/W
#define MPU9250_ACCEL_CONFIG2      0x1D	  // R/W
#define MPU9250_LP_ACCEL_ODR       0x1E   // R/W
#define MPU9250_WOM_THR            0x1F   // R/W

#define MPU9250_FIFO_EN            0x23   // R/W
#define MPU9250_I2C_MST_CTRL       0x24   // R/W
#define MPU9250_I2C_SLV0_ADDR      0x25   // R/W
#define MPU9250_I2C_SLV0_REG       0x26   // R/W
#define MPU9250_I2C_SLV0_CTRL      0x27   // R/W
#define MPU9250_I2C_SLV1_ADDR      0x28   // R/W
#define MPU9250_I2C_SLV1_REG       0x29   // R/W
#define MPU9250_I2C_SLV1_CTRL      0x2A   // R/W
#define MPU9250_I2C_SLV2_ADDR      0x2B   // R/W
#define MPU9250_I2C_SLV2_REG       0x2C   // R/W
#define MPU9250_I2C_SLV2_CTRL      0x2D   // R/W
#define MPU9250_I2C_SLV3_ADDR      0x2E   // R/W
#define MPU9250_I2C_SLV3_REG       0x2F   // R/W
#define MPU9250_I2C_SLV3_CTRL      0x30   // R/W
#define MPU9250_I2C_SLV4_ADDR      0x31   // R/W
#define MPU9250_I2C_SLV4_REG       0x32   // R/W
#define MPU9250_I2C_SLV4_DO        0x33   // R/W
#define MPU9250_I2C_SLV4_CTRL      0x34   // R/W
#define MPU9250_I2C_SLV4_DI        0x35   // R  
#define MPU9250_I2C_MST_STATUS     0x36   // R
#define MPU9250_INT_PIN_CFG        0x37   // R/W
#define MPU9250_INT_ENABLE         0x38   // R/W
#define MPU9250_INT_STATUS         0x3A   // R  
#define MPU9250_ACCEL_XOUT_H       0x3B   // R  
#define MPU9250_ACCEL_XOUT_L       0x3C   // R  
#define MPU9250_ACCEL_YOUT_H       0x3D   // R  
#define MPU9250_ACCEL_YOUT_L       0x3E   // R  
#define MPU9250_ACCEL_ZOUT_H       0x3F   // R  
#define MPU9250_ACCEL_ZOUT_L       0x40   // R  
#define MPU9250_TEMP_OUT_H         0x41   // R  
#define MPU9250_TEMP_OUT_L         0x42   // R  
#define MPU9250_GYRO_XOUT_H        0x43   // R  
#define MPU9250_GYRO_XOUT_L        0x44   // R  
#define MPU9250_GYRO_YOUT_H        0x45   // R  
#define MPU9250_GYRO_YOUT_L        0x46   // R  
#define MPU9250_GYRO_ZOUT_H        0x47   // R  
#define MPU9250_GYRO_ZOUT_L        0x48   // R  
#define MPU9250_EXT_SENS_DATA_00   0x49   // R  
#define MPU9250_EXT_SENS_DATA_01   0x4A   // R  
#define MPU9250_EXT_SENS_DATA_02   0x4B   // R  
#define MPU9250_EXT_SENS_DATA_03   0x4C   // R  
#define MPU9250_EXT_SENS_DATA_04   0x4D   // R  
#define MPU9250_EXT_SENS_DATA_05   0x4E   // R  
#define MPU9250_EXT_SENS_DATA_06   0x4F   // R  
#define MPU9250_EXT_SENS_DATA_07   0x50   // R  
#define MPU9250_EXT_SENS_DATA_08   0x51   // R  
#define MPU9250_EXT_SENS_DATA_09   0x52   // R  
#define MPU9250_EXT_SENS_DATA_10   0x53   // R  
#define MPU9250_EXT_SENS_DATA_11   0x54   // R  
#define MPU9250_EXT_SENS_DATA_12   0x55   // R  
#define MPU9250_EXT_SENS_DATA_13   0x56   // R  
#define MPU9250_EXT_SENS_DATA_14   0x57   // R  
#define MPU9250_EXT_SENS_DATA_15   0x58   // R  
#define MPU9250_EXT_SENS_DATA_16   0x59   // R  
#define MPU9250_EXT_SENS_DATA_17   0x5A   // R  
#define MPU9250_EXT_SENS_DATA_18   0x5B   // R  
#define MPU9250_EXT_SENS_DATA_19   0x5C   // R  
#define MPU9250_EXT_SENS_DATA_20   0x5D   // R  
#define MPU9250_EXT_SENS_DATA_21   0x5E   // R  
#define MPU9250_EXT_SENS_DATA_22   0x5F   // R  
#define MPU9250_EXT_SENS_DATA_23   0x60   // R  

#define MPU9250_I2C_SLV0_DO        0x63   // R/W
#define MPU9250_I2C_SLV1_DO        0x64   // R/W
#define MPU9250_I2C_SLV2_DO        0x65   // R/W
#define MPU9250_I2C_SLV3_DO        0x66   // R/W
#define MPU9250_I2C_MST_DELAY_CTRL 0x67   // R/W
#define MPU9250_SIGNAL_PATH_RESET  0x68   // R/W
#define MPU9250_MOT_DETECT_CTRL    0x69   // R/W
#define MPU9250_USER_CTRL          0x6A   // R/W
#define MPU9250_PWR_MGMT_1         0x6B   // R/W
#define MPU9250_PWR_MGMT_2         0x6C   // R/W
#define MPU9250_FIFO_COUNTH        0x72   // R/W
#define MPU9250_FIFO_COUNTL        0x73   // R/W
#define MPU9250_FIFO_R_W           0x74   // R/W
#define MPU9250_WHO_AM_I           0x75   // R
#define MPU9250_XA_OFFSET_H        0x77   // R/W
#define MPU9250_XA_OFFSET_L        0x78   // R/W
#define MPU9250_YA_OFFSET_H        0x7A   // R/W
#define MPU9250_YA_OFFSET_L        0x7B   // R/W
#define MPU9250_ZA_OFFSET_H        0x7D   // R/W
#define MPU9250_ZA_OFFSET_L        0x7E   // R/W

//MPU9250 Compass ? copied from MPU9150 so can't guarantee this to work
#define AK8963_I2C_ADDR      0x0C
#define AK8963_DEVICE_ID     0x48
#define AK8963_WRITE_MASK    0x00
#define AK8963_READ_MASK     0x01

#define AK8963_WIA           0x00
#define AK8963_INFO          0x01
#define AK8963_ST1           0x02
#define AK8963_HXL           0x03   // R
#define AK8963_HXH           0x04   // R
#define AK8963_HYL           0x05   // R
#define AK8963_HYH           0x06   // R
#define AK8963_HZL           0x07   // R
#define AK8963_HZH           0x08   // R
#define AK8963_ST2           0x09   // R
#define AK8963_CNTL1         0x0A   // R/W
#define AK8963_CNTL2         0x0B
#define AK8963_ASTC          0x0C
#define AK8963_TS1           0x0D
#define AK8963_TS2           0x0E
#define AK8963_I2CDIS        0x0F
#define AK8963_ASAX          0x10
#define AK8963_ASAY          0x11
#define AK8963_ASAZ          0x12

#define WAIT_WHILE(cond) \
  do { \
    volatile int8_t i=0; \
    while(cond) i++; \
  } while(0)

float AK8963_ADJUST_X;
float AK8963_ADJUST_Y;
float AK8963_ADJUST_Z;
uint8_t AK8963_ADJUST_RAW_X, AK8963_ADJUST_RAW_Y; AK8963_ADJUST_RAW_Z;

void mpu9250_init();

uint8_t mpu9250_readWAI();

void ak8963_init(uint8_t mode);

void mpu9250_readByte(uint8_t reg_addr, uint8_t *data);
void ak8963_readByte(uint8_t reg_addr, uint8_t *data);

void mpu9250_readMultiple(uint8_t reg_addr, uint16_t len, uint8_t *data);
void ak8963_readMultiple(uint8_t reg_addr, uint8_t len, uint8_t *data);

void mpu9250_writeByte(uint8_t reg_addr, uint8_t data);
void ak8963_writeByte(uint8_t reg_addr, uint8_t data);

// writes data to register reg_addr
void mpu9250_writeSensor(uint8_t reg_addr, uint8_t data);

/* reads from register reg_addrL and reg_addrH
*  the sensor data of the MPU9150 are 16bits so you have to read the lower and
*  upper 8bits separately to read from a specific register, write the address
*  of the register you want to read to the slave then read from slave device
*/
int16_t mpu9250_readSensor(uint8_t reg_addrL, uint8_t reg_addrH);

uint8_t ak8963_readWIA();
int8_t ak8963_read_Mag(uint8_t *data);


void mpu9250_int_clear();

/*	
*	\brief		Enables Wake-On-Motion Interrupt
*				To be called immediately after mpu9250_init()
*	\param WOM_Threshold	8 bit value setting the threshold limit
*							LSB = 4mg, Range 0mg to 1024mg
*	\param Wakeup_Frequency	8 bit value Sets the frequency of waking up the chip
*							to take a sample of accel data at the low power accel 
*							Output Data Rate; greater freq = higher power draw
*	\param callback 		a callback function of type gpio_callback_t to be registered
*							with the isr
*/
void mpu9250_motion_interrupt_init(uint8_t WOM_Threshold, uint8_t Wakeup_Frequency);
void mpu9250_interrupt_enable(gpio_callback_t accel_irq_handler);
void mpu9250_interrupt_disable();

void temp_irq_handler(uint8_t port, uint8_t pin);
//void accel_irq_handler(uint8_t port, uint8_t pin);

#endif /*MPU9250_H*/
