lab11/observer/contiki/dev/spiSlave/spiSlave.c

/* CC2538 SPI Slave driver
 *
 * Author: Ye-Sheng Kuo <samkuo@umich.edu>
 *
 */

#include "spiSlave.h"

static spi_callback_t spi0_callback;
static spi_callback_t spi1_callback;

void spix_slave_init(uint8_t spi){
  if (spi > SSI_INSTANCE_COUNT)
    return;

  const spi_slave_reg_t* regs = &spi_slave_regs[spi];

  if (regs->clk.port < 0)
    return;

  /* Enable the clock for the SSI peripheral */
  spix_slave_enable(spi);

  /* Start by disabling the peripheral before configuring it */
  REG(regs->base + SSI_CR1) = 0;

  /* Set to Spi Slave */
  REG(regs->base + SSI_CR1) |= SSI_CR1_MS_M;

  /* Set the IO clock as the SSI clock */
  REG(regs->base + SSI_CC) = 1;

  /* Set the mux correctly to connect the SSI pins to the correct GPIO pins */
  ioc_set_sel(regs->miso.port, regs->miso.pin, regs->ioc_pxx_sel_ssi_txd);
  REG(regs->ioc_clk_ssiin_ssi) = (regs->clk.port<<3) + regs->clk.pin;
  REG(regs->ioc_ssirxd_ssi) = (regs->mosi.port<<3) + regs->mosi.pin;
  REG(regs->ioc_ssifssin_ssi) = (regs->cs.port<<3) + regs->cs.pin;

  /* Put all the SSI gpios into peripheral mode */
  GPIO_PERIPHERAL_CONTROL(GPIO_PORT_TO_BASE(regs->clk.port), 
                          GPIO_PIN_MASK(regs->clk.pin));
  GPIO_PERIPHERAL_CONTROL(GPIO_PORT_TO_BASE(regs->mosi.port), 
                          GPIO_PIN_MASK(regs->mosi.pin));
  GPIO_PERIPHERAL_CONTROL(GPIO_PORT_TO_BASE(regs->miso.port), 
                          GPIO_PIN_MASK(regs->miso.pin));
  GPIO_PERIPHERAL_CONTROL(GPIO_PORT_TO_BASE(regs->cs.port), 
                          GPIO_PIN_MASK(regs->cs.pin));

  /* Disable any pull ups or the like */
  ioc_set_over(regs->clk.port, regs->clk.pin, IOC_OVERRIDE_DIS);
  ioc_set_over(regs->mosi.port, regs->mosi.pin, IOC_OVERRIDE_DIS);
  ioc_set_over(regs->cs.port, regs->cs.pin, IOC_OVERRIDE_DIS);

  /* Configure the clock */
  REG(regs->base + SSI_CPSR) = 8;

  /* Configure the default SPI options.
   *   mode:  Motorola frame format
   *   clock: High when idle
   *   data:  Valid on rising edges of the clock
   *   bits:  8 byte data
   */
  // Set it to 9 bit per data, for edison extra bit
  //REG(regs->base + SSI_CR0) = SSI_CR0_SPH | SSI_CR0_SPO | (0x08);
  REG(regs->base + SSI_CR0) = SSI_CR0_SPH | SSI_CR0_SPO | (0x07);

  /* Enable the SSI */
  REG(regs->base + SSI_CR1) |= SSI_CR1_SSE;
}

// release clock gating
void spix_slave_enable(uint8_t spi){
  REG(SYS_CTRL_RCGCSSI) |= (1<<spi);
  REG(SYS_CTRL_DCGCSSI) |= (1<<spi);
  //REG(SYS_CTRL_SCGCSSI) |= (1<<spi);
}

// return 1 if rx fifo is empty
inline int spix_check_rx_fifo_empty(uint8_t spi){
  const spi_slave_reg_t* regs = &spi_slave_regs[spi];
  if ((REG(regs->base + SSI_SR) & SSI_SR_RNE_M) > 0)
    return 0;
  else
    return 1;
}

// return 1 if tx fifo is full
inline uint32_t spix_check_tx_fifo_full(uint8_t spi){
  const spi_slave_reg_t* regs = &spi_slave_regs[spi];
  if ((REG(regs->base + SSI_SR) & SSI_SR_TNF_M) > 0)
    return 0;
  else
    return 1;
  
}

uint8_t spix_get_data(uint8_t spi, uint8_t* data){
  const spi_slave_reg_t* regs = &spi_slave_regs[spi];
  uint8_t dataLen = 0;
  while ((REG(regs->base + SSI_SR) & SSI_SR_RNE_M) > 0){
    data[dataLen] = (uint8_t)(REG(regs->base + SSI_DR) & SSI_DR_DATA_M);
    dataLen += 1;
  }
  return dataLen;
}

void spix_put_data(uint8_t spi, uint8_t* data, uint8_t data_length){
  const spi_slave_reg_t* regs = &spi_slave_regs[spi];
  uint8_t i;
  for (i=0; i<data_length; i++){
    while (spix_check_tx_fifo_full(spi)){}
    REG(regs->base + SSI_DR) = data[i];
  }
}

void spix_put_data_single(uint8_t spi, uint8_t data){
  const spi_slave_reg_t* regs = &spi_slave_regs[spi];
  while (spix_check_tx_fifo_full(spi)){}
  REG(regs->base + SSI_DR) = data;
}

void spix_interrupt_enable(uint8_t spi, uint32_t interruptFlags){
    const spi_slave_reg_t* regs = &spi_slave_regs[spi];
    REG(regs->base + SSI_IM) |= interruptFlags;
}

void spix_interrupt_disable(uint8_t spi, uint32_t interruptFlags){
    const spi_slave_reg_t* regs = &spi_slave_regs[spi];
    REG(regs->base + SSI_IM) &= (~interruptFlags);
}

uint32_t spix_interrupt_get_status(uint8_t spi, uint8_t masked){
    const spi_slave_reg_t* regs = &spi_slave_regs[spi];
    if (masked)
        return REG(regs->base + SSI_MIS);
    else
        return REG(regs->base + SSI_RIS);
}

void spix_interrupt_clear(uint8_t spi, uint32_t interruptFlags){
    const spi_slave_reg_t* regs = &spi_slave_regs[spi];
    REG(regs->base + SSI_ICR) = interruptFlags;
}

void spi_register_callback(uint8_t spi, spi_callback_t f){
  if (spi == 0) {
	spi0_callback = f;
  } else if (spi == 1) {
	spi1_callback = f;
  } else {
	return;
  }
}

// register to ssi0 isr
void spi0_isr() {
  lpm_exit();
  (*spi0_callback)();
  ENERGEST_OFF(ENERGEST_TYPE_IRQ);
}

// register to ssi1 isr
void spi1_isr() {
    lpm_exit();
	(*spi1_callback)();
	ENERGEST_OFF(ENERGEST_TYPE_IRQ);
}

void spix_txdma_enable(uint8_t spi){
    const spi_slave_reg_t* regs = &spi_slave_regs[spi];
    REG(regs->base + SSI_DMACTL) |= SSI_DMACTL_TXDMAE;
}

void spix_txdma_disable(uint8_t spi){
    const spi_slave_reg_t* regs = &spi_slave_regs[spi];
    REG(regs->base + SSI_DMACTL) &= (~SSI_DMACTL_TXDMAE);
}

void spix_rxdma_enable(uint8_t spi){
    const spi_slave_reg_t* regs = &spi_slave_regs[spi];
    REG(regs->base + SSI_DMACTL) |= SSI_DMACTL_RXDMAE;
}

void spix_rxdma_disable(uint8_t spi){
    const spi_slave_reg_t* regs = &spi_slave_regs[spi];
    REG(regs->base + SSI_DMACTL) &= (~SSI_DMACTL_RXDMAE);
}

uint8_t spix_busy(uint8_t spi){
    const spi_slave_reg_t* regs = &spi_slave_regs[spi];
    return (REG(regs->base + SSI_SR) & SSI_SR_BSY_M)>>SSI_SR_BSY_S;
}
