lab11/observer/contiki/apps/observer_lp/project-conf.h

#ifndef PROJECT_CONF_H_
#define PROJECT_CONF_H_

/*
 * @author: Brad Campbell <bradjc@umich.edu>
 */

// No need for UART
#define STARTUP_CONF_VERBOSE 0
#define UART_CONF_ENABLE 0
#define SPI_CONF_DEFAULT_INSTANCE 0
//#define NETSTACK_CONF_WITH_IPV6 0

 //#define CC2538_CONF_QUIET 0

//#define ENERGEST_CONF_ON 1

//#define NO_CLOCK_DIVIDER_RESTORE 1

#endif /* PROJECT_CONF_H_ */

/** @} */
