lab11/observer/(commit log)

2015-03-26 revert blink.c to normal
    [blink.c]
2015-03-28 started driver for pressure (lps331ap)
2015-03-28 turn on sensor and poll who am i
2015-03-30 fixed read function SPI CS timing
    [lps331ap.c]
2015-03-30 Working reads from the pressure sensor
2015-03-31 Started implementing irq handler for pressure
2015-04-02 added rev a files
    [observer.brd, observer.sch, observer_bom.csv, observer_bom.xlsx]
2015-04-04 Added reva hcape
    [observer.brd, observer.sch, observer_bom.csv, observer_bom.xlsx, ocape.brd, ocape.sch, ocape_bom.csv, ocape_bom.xlsx]
2015-04-05 added schematic for the microphone
2015-04-05 Updated bbb header device
2015-04-05 Started observer rev b
    [observer.brd, observer.sch]
2015-04-06 started routing
    [observer.brd, observer.sch]
2015-04-06 added in the ADC
2015-04-06 Finished routing header signals, need to add mousebites and microphone hardware
    [observer.brd]
2015-04-07 added mic and opamp to sch
    [observer.brd, observer.sch]
2015-04-07 added mousebites
    [observer.brd]
2015-04-07 small change to mousebites
    [observer.brd]
2015-04-07 updated ADC
2015-04-07 Finished routing, needs to be looked over for correctness
    [observer.brd, observer.sch]
2015-04-07 Fixed header on motherboard, added decoupling cap for op amp
    [observer.brd, observer.sch]
2015-04-07 fixed some spacing issues
    [observer.brd]
2015-04-07 Fixed clearance issues near BBB header and mousebites
    [observer.brd]
2015-04-07 started bom, need to rename caps/res in order of increasing value
    [observer_bom.csv]
2015-04-07 added excel sheet, need to rename passives
    [observer_bom.xlsx]
2015-04-07 Renamed passives in order of increasing value, highlighted parts needed in bom
    [observer.brd, observer.sch, observer_bom.xlsx]
2015-04-07 added all missing digikey part numbers new parts highlighted in orange
    [observer_bom.xlsx]
2015-04-08 Shipped off board, fixed DRU errors.
    [observer.brd, observer.sch]
2015-04-13 testing spi for mpu9250
2015-04-13 Removed timers from accelerometer, works
2015-04-15 si1147: disable watchdog timer
2015-04-15 si1147: can do forced mode, working on interrupts
2015-04-16 si1147: modified ADC params
2015-04-16 mpu9250: in main dir fixed a the startup time
    [mpu9250.c, mpu9250.h]
2015-04-17 Sensor reading correct data
    [project-conf.h, si7021.c, si7021.h]
2015-04-17 adc121c021: successive write/reads not working
    [adc121c021.c, adc121c021.h, project-conf.h]
2015-04-18 gave up on stupid SPI reads, should give accurate reads
2015-04-18 observer-main: pressure/accel don't work together
2015-04-19 Changed to use iterating reads/writes and utilizing SPI flush LPS331AP now reports correct readings
    [lps331ap.c, lps331ap.h]
2015-04-19 Moved driver source for lps331ap to contiki/dev
2015-04-19 Moved drivers to /dev and updated main process
2015-04-19 Added spi flush to mpu9250
2015-04-20 standardized printing
2015-04-20 observer-main: working with all sensors but the microphone
2015-04-20 Cynthia's adc code that was on yorkpatty
2015-04-20 ADC working and added to the main process
2015-04-20 main can poll sensors for data and send packets to beaglebone
2015-04-21 changed ADC
2015-04-21 fixed adc hang
2015-04-21 changed adc algorithm
2015-05-21 added interrupts for mpu9250, revised isr: disables interrupts, polls main process, main process responsible for enabling interrups before sleeping (this done to provide atomicity)
2015-05-21 forgot to commit actual drivers in last commit: amn41122 and mpu9250
2015-05-27 old source/makefiles do not work with current version of contiki; updated for support
    [board.h, contiki-conf.h, contiki-main.c, fm25l04b.c, lps331ap.c, mpu9250.c, observer-main.c, project-conf.h]
2015-06-19 forgot to initialize spi
2015-06-25 observer rev_c
    [observer.brd, observer.sch, observer_bom.csv, observer_bom.xlsx]
2015-06-25 observer low power tests
2015-06-29 connected opamp gate signal to header for debugging
    [observer.brd, observer.sch]
2015-06-29 updated zip to fab for the revised board
2015-06-30 lps331ap oneshot working, removed old board zip to fabs
2015-07-22 switched from using rtimer to vtimer for periodic wakeup
2015-07-23 power-up int accel, broke stuff :shit:
    [mpu9250.c, mpu9250.h]
2015-08-20 power-up interrupts return with interrupts disabled, main process restores interrupts so that peripherals aren't interrupted when reading and transmitting is atomic
2015-08-26 moved callbacks to main process source file; generalized interrupt enable functions for pir and rtc
2015-08-26 changed flag check from led to global variable
2015-08-27 added crc check for temp/humid sensor
2015-08-27 forgot to disable interrupts in pir handler
2015-08-28 changed callback to include arguments, probably won't fix the problem
    [observer_lp.c]
2015-09-03 overhauled event processing, might break? currently deployed and testing
2015-09-03 changed demo to extract time from the packet, GATD deduplicator still can't filter correctly
2016-01-30 accel power up int; press oneshot; still need gpio for lowpower
2016-01-31 still drawing 3mA; can't pinpoint where
2016-02-01 added light int pullup; connected amp to pfet drain; voltage regulator output 2.8V;
    [observer.brd, observer.sch]
2016-02-01 rev_d gerbers
    [observer.brd]
2016-02-01 deleted temp board files
2016-03-21 incremental low power updates
2016-03-22 more incremental power changes/correct pin assignments
    [power_manage2.h]
2016-03-22 still functioning, didn't break
    [blink.c]
2016-03-22 fixed spi/rtc working in lpm with rtimer
    [blink.c]
2016-03-22 reduced process thread size/no names
2016-03-22 clear int before enable alarm, just in case
2016-03-23 mpu must be last spi before sleep for some reason; maybe hanging/idling when other spi transactions occur? b/c changing spi mode doesn't fix nor lps as last spi (which uses same spi mode)
    [blink.c, mpu9250.c, mpu9250.h, power_manage2.h]
2016-03-23 mpu latch in separate process works; mpu must be last spi possibly b/c of shared I2C lines putting it into weird state when other spi trans occurs but can't disable I2C b/c need magnetometer
2016-03-23 lpm working with all periphs on board;can't figure out how to change mpu mode to read magnetometer
2016-03-23 can sample all periphs and broadcast; seems to return to low power state
2016-03-23 working without accel int (but still need to set pin up for input, or else floating
2016-03-24 increase tx power
2016-03-24 fixed interrupt firing when re-enabling wake-up interrupt
    [blink.c]
2016-03-24 fixed mpu mystery drain, i2c shared with spi lines so unless mpu was last spi transmission, it would think it got i2c trans and get into weird state
    [blink.c, mpu9250.c]
2016-03-25 update mpu interrupt config; using RMW for enabling i2c master on mpu; can communicate with ak8963, just need to disable i2c master on mpu before sleeping
2016-03-25 must disable I2C master before sleeping; need to disable cycling then wait at most(?) 10ms before reconfiguring mpu to do other things like enabling I2C master, must disable I2C master and reenable c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
2016-04-05 moved pir rtimer to interrupt handler to keep atomic; moved pir int enable after busy loop to avoid getting into weird state at start
    [blink.c]
2016-04-20 spi slave on ssi1 working
2016-04-20 spiSlave driver adapted from yesheng's
2016-04-20 changed spi clock divider
